floesche/LED-Display_G4_Hardware_Arena/arena_06-inf/arena_06-inf_teensy/assets/arena_06-inf_teensy_back.png

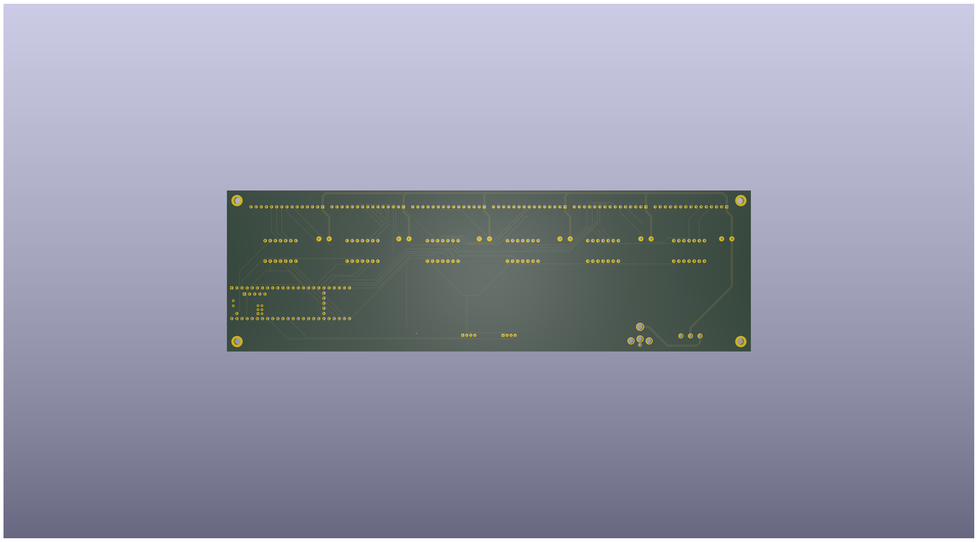
arena_06-inf/arena_06-inf_teensy/assets/arena_06-inf_teensy_back.png
