floesche/LED-Display_G4_Hardware_Arena/arena_12-12/arena_12-12_v8_ni/assets/arena_12-12_v8_ni_front.png

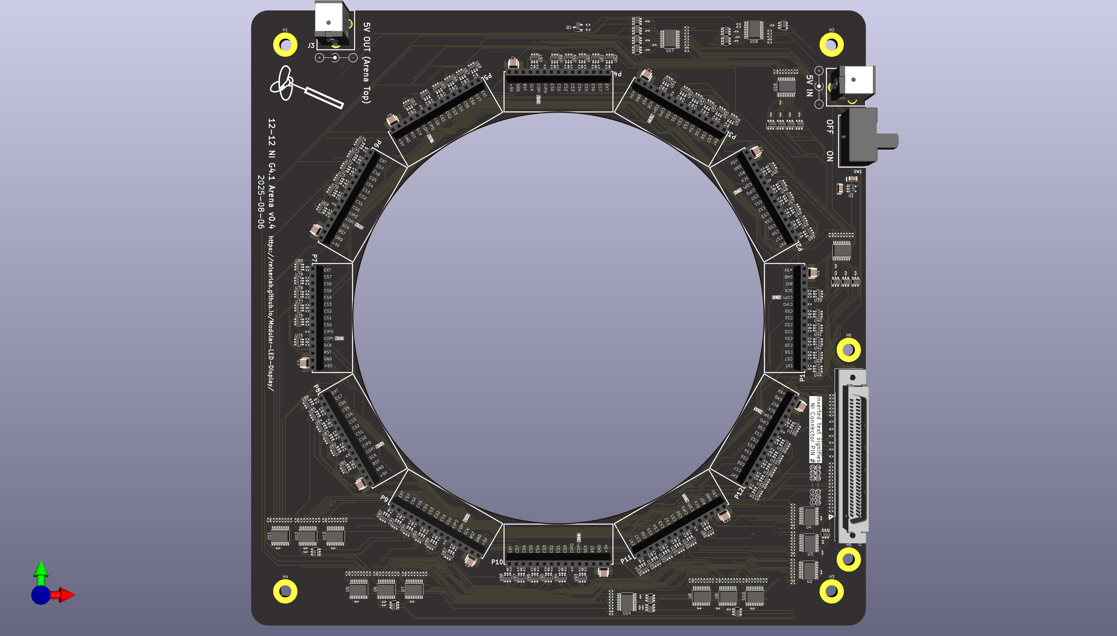
arena_12-12/arena_12-12_v8_ni/assets/arena_12-12_v8_ni_front.png
