floesche/LED-Display_G4_Hardware_Arena/arena_12-12/arena_12-12_v10_teensy/assets/arena_12-12_v10_teensy_back.png

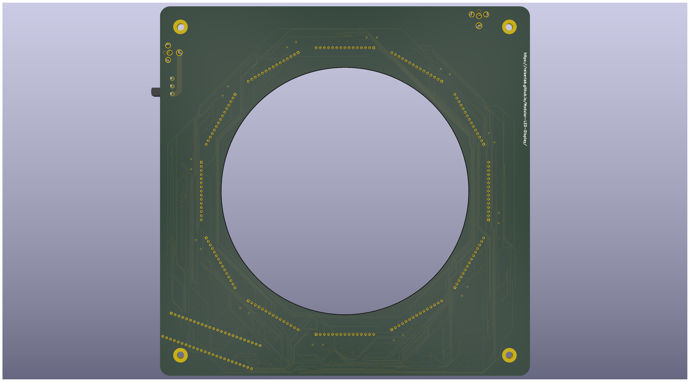
arena_12-12/arena_12-12_v10_teensy/assets/arena_12-12_v10_teensy_back.png
