floesche/LED-Display_G4_Hardware_Arena/arena_12-12/arena_12-12_v12_belt/assets/arena_12-12_v12_belt_back.png

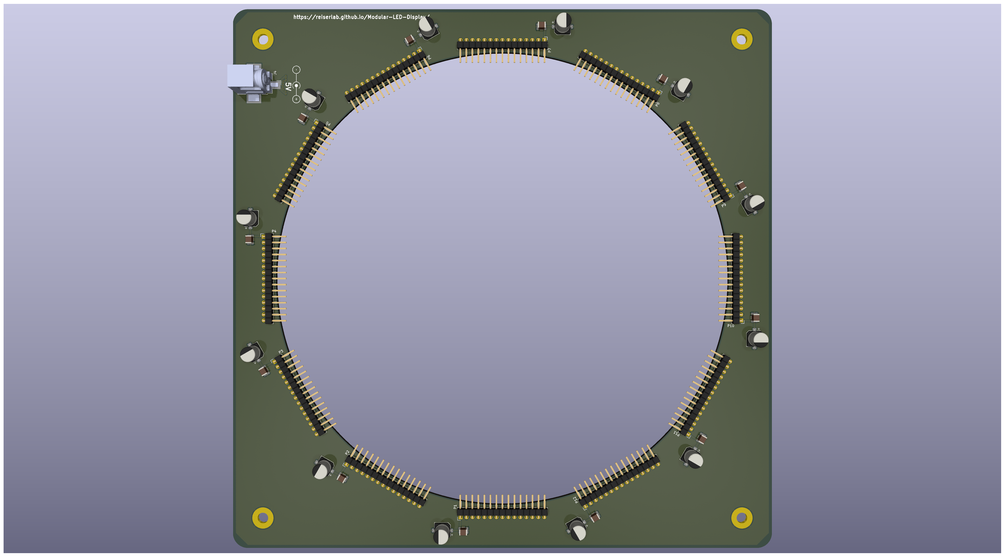
arena_12-12/arena_12-12_v12_belt/assets/arena_12-12_v12_belt_back.png
