floesche/LED-Display_G4_Hardware_Arena/docs/assets/arena_6-inf_v0p1_controller_photo.png

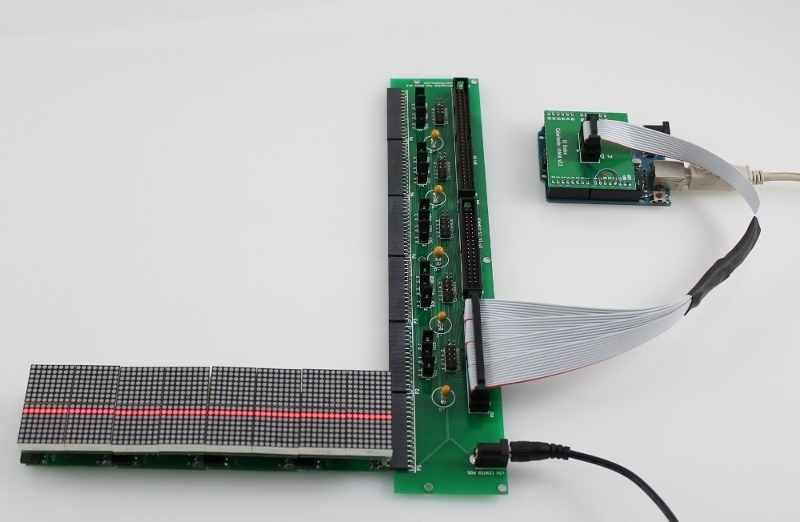
docs/assets/arena_6-inf_v0p1_controller_photo.png
