floesche/LED-Display_G4_Hardware_Arena/arena_06-inf/arena_06-inf_atmega328/production/BOM-v0p1.xls

Item # | Qty | Reference | Descritpion | P/N | Vendor
1 | 5 | C1-C5 | 10uF tantulum capacitor, 25V | 478-4170-ND | Digikey
2 | 6 | P1-P6 | 15x1 female header, right angle | S5490-ND or SAM1195-15-ND | Digikey
3 | 15 | P7-P21 | 2x2 male header, break away | S2011EC-40-ND | Digikey
4 | 2 | P22, P30 | 20x2 male header, shrouded | S9175-ND | Digikey
5 | 1 | P23 | 30x2 male header, shrouded | OR968-ND | Digikey
6 | 1 | P24 | 2.1mm DC Jack 2-pin | 137673 | Jameco
7 | 5 | P25-P29 | 5x2 male header | S2011EC-40-ND | Digikey
Extra
1 | 1 | P22,P30 | connector socket IDC 40 position | S9326-ND | Digikey
2 | 1 | P23 | connector socket IDC 60 position | OR978-ND | Digikey
