floesche/LED-Display_G4_Hardware_Arena/arena_06-inf/arena_06-inf_atmega328/production/BOM-v0p2.xls

Item # | Qty | Reference | Descritpion | P/N | Vendor
1 | 5 | C1-C5 | 10uF tantulum capacitor, 25V | 478-4170-ND | Digikey
2 | 6 | P1-P6 | 15x1 female header, right angle | S5490-ND or SAM1195-15-ND | Digikey
3 | 2 | P7, P10 | 20x2 male header, shrouded | S9175-ND | Digikey
4 | 1 | P8 | 68-pin DSUB for NI cable, TE Connectivity | A33476-ND | Digikey
5 | 1 | Q1 | MOSFET N-Channel | SI2302-TPMSCT-ND | Digikey
6 | 1 | R1 | Resistor, 200 SM0805 | RHM200KCT-ND | Digikey
7 | 1 | R2 | Resistor, 20k SM0805 | P20.0KCCT-ND | Digikey
8 | 1 | SW1 | Slide switch | CKC5102-ND | Digikey
9 | 1 | P9 | 2.1mm DC Jack 2-pin | 137673 | Jameco
Extra
1 | 1 | P22,P30 | connector socket IDC 40 position | S9326-ND | Digikey
2 | 1 | P23 | connector socket IDC 60 position | OR978-ND | Digikey
