floesche/LED-Display_G4_Hardware_Arena/arena_06-inf/arena_06-inf_atmega328/production/BOM-v0p3.xls

Item # | Qty | Reference | Descritpion | P/N | Vendor | unit price
1 | 5 | C1-C5 | 10uF tantulum capacitor, 25V | 478-4170-ND | Digikey | 0.98 | 24 | 23.52
2 | 6 | P1-P6 | 15x1 female header, right angle | S5490-ND or SAM1195-15-ND | Digikey | 2.26 | 12 | 27.12
3 | 2 | P7, P10 | 20x2 male header, shrouded | S9175-ND | Digikey | 0.91 | 2 | 1.82
4 | 1 | P8 | 68-pin DSUB for NI cable, TE Connectivity | A33476-ND | Digikey | 24.82 | 1 | 24.82
5 | 1 | Q1 | MOSFET N-Channel | SI2302-TPMSCT-ND | Digikey | 0.49 | 1 | 0.49
6 | 1 | R1 | Resistor, 200 SM0805 | RHM200KCT-ND | Digikey | 0.1 | 1 | 0.1
7 | 1 | R2 | Resistor, 20k SM0805 | P20.0KCCT-ND | Digikey | 0.1 | 1 | 0.1
8 | 6 | R3–R8 | Resistor 100Ohm | S100QCT-ND | Digikey | 0.1 | 12 | 1.2
9 | 1 | SW1 | Slide switch | CKC5102-ND | Digikey | 2.23 | 2 | 4.46
10 | 1 | P9 | 2.1mm DC Jack,high current | CP-063AH-ND | Digikey | 1.78 | 2 | 3.56
11 | 7 | U1-U7 | Voltage-Level Translator Breakout – TXB0104 | BOB-11771 | Sparkfun | 3.95 | 13 | 51.35
12 | 1 | U8 | 3.3V, 600mA step down voltage regulator | 2106 | Pololu | 5.95 | 1 | 5.95
 |  |  |  |  |  |  |  | 0
Extra |  |  |  |  |  |  |  | 0
1 | 2 | P22,P30 | connector socket IDC 40 position | S9326-ND | Digikey | 1.54 | 2 | 3.08
 |  |  |  |  |  | 1.6 | 6 | 9.6
 |  |  |  |  |  |  |  | 157.17 | 785.85
