floesche/LED-Display_G4_Hardware_Arena/arena_06-inf/arena_06-inf_max6960/production/BOM-v0p1.xls

Item # | Qty | Reference | Descritpion | P/N | Vendor
1 | 5 | C1-C5 | 10uF tantulum capacitor, 25V | 478-4170-ND | Digikey
2 | 1 | C6 | 0.1uF ceramic capacitor, SM0603 | 445-1316-1-ND | Digikey
3 | 6 | P1-P6 | 15x1 female header, right angle | S5490-ND, SAM1195-15-ND | Digikey
4 | 15 | P7-P21, P25 | 2x2 male header, break away | S2011EC-40-ND | Digikey
5 | 2 | P22, P32 | 20x2 male header, shrouded | S9175-ND | Digikey
6 | 1 | P23 | 30x2 male header, shrouded | OR968-ND | Digikey
7 | 2 | P24, P26 | 2.1mm DC Jack 2-pin | 137673 | Jameco
8 | 5 | P27-P31 | 5x2 male header | S2011EC-40-ND | Digikey
9 | 1 | U1 | MAX7375, | MAX7375AXR425+TCT-ND | Digikey
Extra
1 | 1 | P22,P30 | connector socket IDC 40 position | S9326-ND | Digikey
2 | 1 | P23 | connector socket IDC 60 position | OR978-ND | Digikey
