floesche/LED-Display_G4_Hardware_Arena/arena_06-inf/arena_06-inf_raspberry-pi/production/BOM-v0p1.xls

Item # | Qty | Reference | Descritpion | P/N | Vendor
1 | 5 | C1-C6 | 10uF tantalum capacitor, 25V | 478-4170-ND | Digikey
2 | 1 | J1 | 2.1mm DC Jack,high current | CP-063AH-ND | Digikey
3 | 6 | P1-P6 | 15x1 female header, right angle | SAM1195-15-ND | Digikey
4 | 1 | Q2 | MOSFET N-Channel | SI2302-TPMSCT-ND | Digikey
5 | 1 | R1 | Resistor, 200 Ohms, SM0805 | RHM200KCT-ND | Digikey
6 | 1 | R2 | Resistor, 20k SM0805 | P20.0KCCT-ND | Digikey
7 | 1 | SW1 | Slide switch | CKC5102-ND | Digikey
8 | 6 | U1-U6 | Voltage-Level Translator Breakout – TXB0104 | 1568-1208-ND | Digikey
9 | 1 | U10 | Raspberry Pi Pico RP2040 | 2648-SC0915CT-ND | Digikey
