floesche/LED-Display_G4_Hardware_Arena/arena_12-12/arena_12-12_v8_ni/production/version_0p3r4/bom_v0.3.4.csv

Designator | Footprint | Quantity | Value | LCSC Part #
C1, C10, C11, C12, C2, C3, C4, C5, C6, C7, C8, C9 | 1210 | 12 | 100uF | C7432790
C100, C101, C102, C103, C104, C105, C106, C107, C108, C109, C110, C111, C112, C113, C114, C115, C116, C117, C118, C119, C120, C121, C122, C123, C124, C125, C126, C127, C128, C129, C130, C131, C132, C133, C134, C135, C136, C137, C138, C139, C140, C15, C16, C17, C18, C19, C20, C21, C22, C23, C24, C25, C26, C27, C28, C29, C30, C31, C32, C33, C34, C35, C36, C37, C38, C39, C40, C41, C42, C43, C44, C45, C46, C47, C48, C49, C50, C51, C52, C53, C54, C55, C56, C57, C58, C59, C60, C61, C62, C63, C64, C65, C66, C67, C68, C69, C70, C71, C72, C73, C74, C75, C76, C77, C78, C79, C80, C81, C82, C83, C84, C85, C86, C87, C88, C89, C90, C91, C92, C93, C94, C95, C96, C97, C98, C99 | 0402 | 126 | 0.1uF | C1525
C13, C14 | 1206 | 2 | 10uF | C342827
J1, J3 | DCJACK_2PIN_HIGHCURRENT | 2 | Barrel_Jack | C2928097
J2 | TE_CONN_DSUB_VERT_68 | 1 | NI_TE_68pos | C5172587
P1, P10, P11, P12, P2, P3, P4, P5, P6, P7, P8, P9 | HEADER_TOP | 12 | CONN15 | C18078136
Q1 | SOT-23-3 | 1 | MOSFET_NCHAN | C165220
R1, R10, R100, R101, R102, R103, R104, R105, R106, R107, R108, R109, R11, R110, R111, R112, R113, R114, R115, R116, R117, R118, R119, R12, R120, R121, R122, R123, R124, R125, R126, R127, R128, R129, R13, R130, R131, R132, R133, R134, R135, R136, R137, R138, R139, R14, R140, R141, R142, R143, R144, R145, R146, R147, R148, R149, R15, R150, R151, R152, R153, R154, R155, R156, R157, R158, R159, R16, R160, R161, R162, R163, R164, R165, R166, R167, R168, R169, R17, R170, R171, R172, R173, R174, R175, R176, R177, R178, R179, R18, R180, R181, R182, R183, R184, R185, R186, R187, R188, R189, R19, R190, R191, R192, R193, R194, R195, R196, R197, R198, R199, R2, R20, R200, R201, R202, R203, R204, R205, R206, R207, R208, R209, R21, R210, R211, R212, R213, R214, R215, R216, R217, R218, R219, R22, R220, R221, R222, R223, R224, R225, R226, R227, R228, R229, R23, R230, R231, R232, R233, R234, R235, R236, R237, R238, R239, R24, R240, R241, R242, R243, R244, R245, R246, R247, R248, R249, R25, R250, R251, R252, R253, R254, R255, R256, R257, R258, R259, R26, R260, R261, R262, R263, R264, R265, R266, R267, R268, R269, R27, R270, R271, R272, R273, R274, R275, R276, R277, R278, R279 | 0402 | 200 | 33 | C25105
R28, R280, R281, R282, R283, R284, R285, R286, R287, R288, R289, R29, R290, R291, R292, R293, R294, R295, R296, R297, R298, R299, R3, R30, R300, R301, R302, R303, R304, R305, R306, R31, R32, R33, R34, R35, R36, R37, R38, R39, R4, R40, R41, R42, R43, R44, R45, R46, R47, R48, R49, R5, R50, R51, R52, R53, R54, R55, R56, R57, R58, R59, R6, R60, R61, R62, R63, R64, R65, R66, R67, R68, R69, R7, R70, R71, R72, R73, R74, R75, R76, R77, R78, R79, R8, R80, R81, R82, R83, R84, R85, R86, R87, R88, R89, R9, R90, R91, R92, R93, R94, R95, R96, R97, R98, R99 | 0402 | 106 | 33 | C25105
R307 | 0402 | 1 | 20k | C25765
R308 | 0402 | 1 | 200 | C25087
SW1 | slide_switch | 1 | SW_SPDT | C2798743
U1 | SOT-23-5 | 1 | AP2112K-3.3 | C51118
U10, U11, U12, U13, U14, U15, U16, U17, U18, U2, U3, U4, U5, U6, U7, U8, U9 | TSSOP-20_4.4x6.5mm_P0.65mm | 17 | TXB0108PW | C53406
U100, U101, U102, U103, U104, U105, U106, U107, U108, U109, U110, U19, U20, U21, U22, U23, U24, U25, U26, U27, U28, U29, U30, U31, U32, U33, U34, U35, U36, U37, U38, U39, U40, U41, U42, U43, U44, U45, U46, U47, U48, U49, U50, U51, U52, U53, U54, U55, U56, U57, U58, U59, U60, U61, U62, U63, U64, U65, U66, U67, U68, U69, U70, U71, U72, U73, U74, U75, U76, U77, U78, U79, U80, U81, U82, U83, U84, U85, U86, U87, U88, U89, U90, U91, U92, U93, U94, U95, U96, U97, U98, U99 | SOT-23-6 | 92 | 74LVC2G17 | C10429
