floesche/LED-Display_G4_Hardware_Arena/arena_06-inf/arena_06-inf_teensy/assets/arena_06-inf_teensy.step

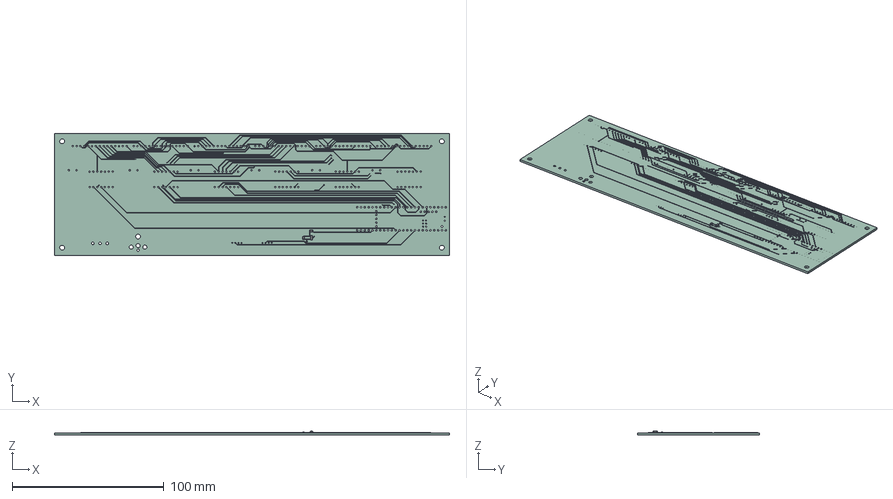
[picture p27: CAD file, 2025-11-14]
arena_06-inf/arena_06-inf_teensy/assets/arena_06-inf_teensy.step
260.0 x 80.0 x 2.83 mm
R_0805_2012Metric x 2
SOT-23-3
arena_06-inf_teensy_copper
arena_06-inf_teensy_via
arena_06-inf_teensy_PCB
