floesche/LED-Display_G4_Hardware_Arena/arena_12-12/arena_12-12_G4.1_top/assets/arena_top_12-12_0.4.2.step

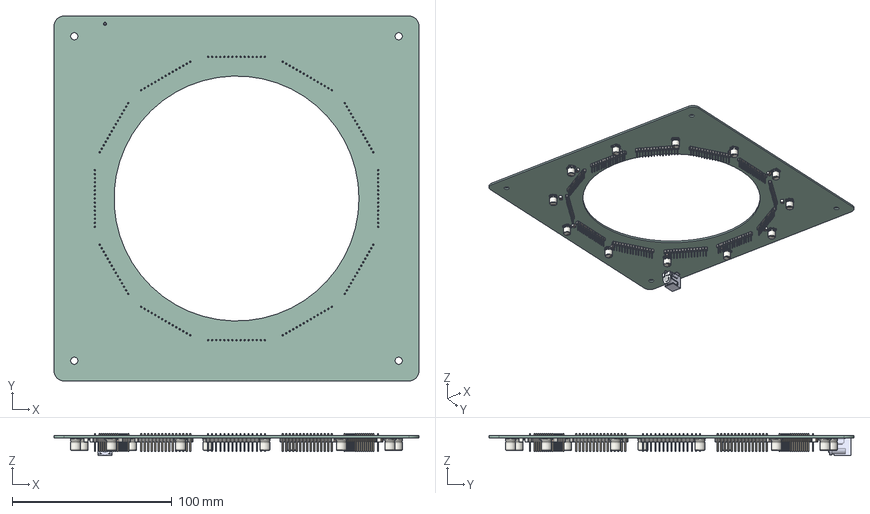
[picture p28: CAD file, 2025-07-25]
arena_12-12/arena_12-12_G4.1_top/assets/arena_top_12-12_0.4.2.step
228.6 x 228.6 x 14.0 mm
CP_Elec_6.3x7.7 x 12
C_1210_3225Metric x 12
Same_Sky_PJ-036AH-SMT-TR
PinHeader_1x15_P2.54mm_Vertical x 12
arena_top_12-12_PCB
