floesche/LED-Display_G4_Hardware_Arena/docs/assets/arena_12-12_v10_teensy_schematics.pdf

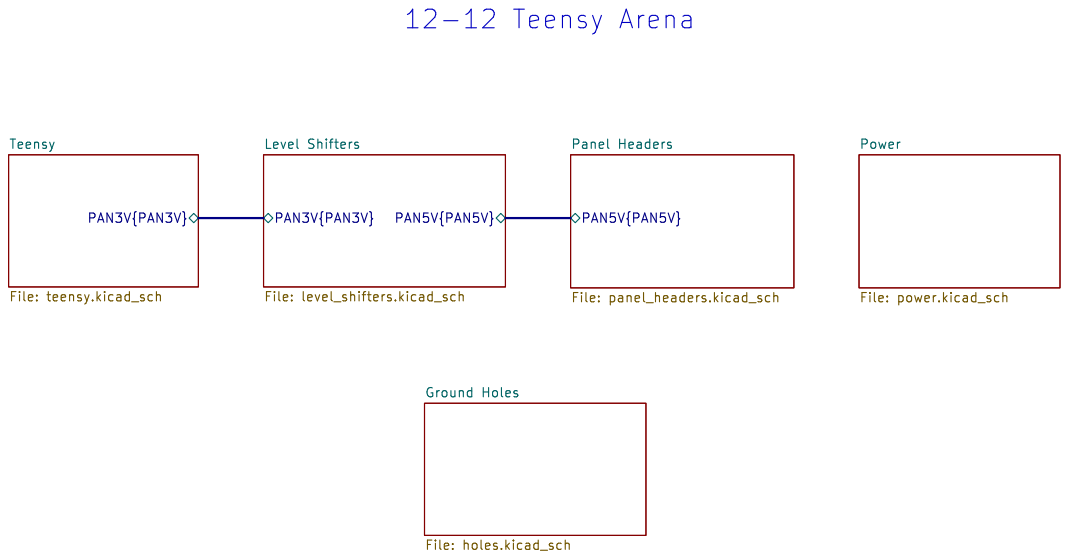
[picture p29: page 1]

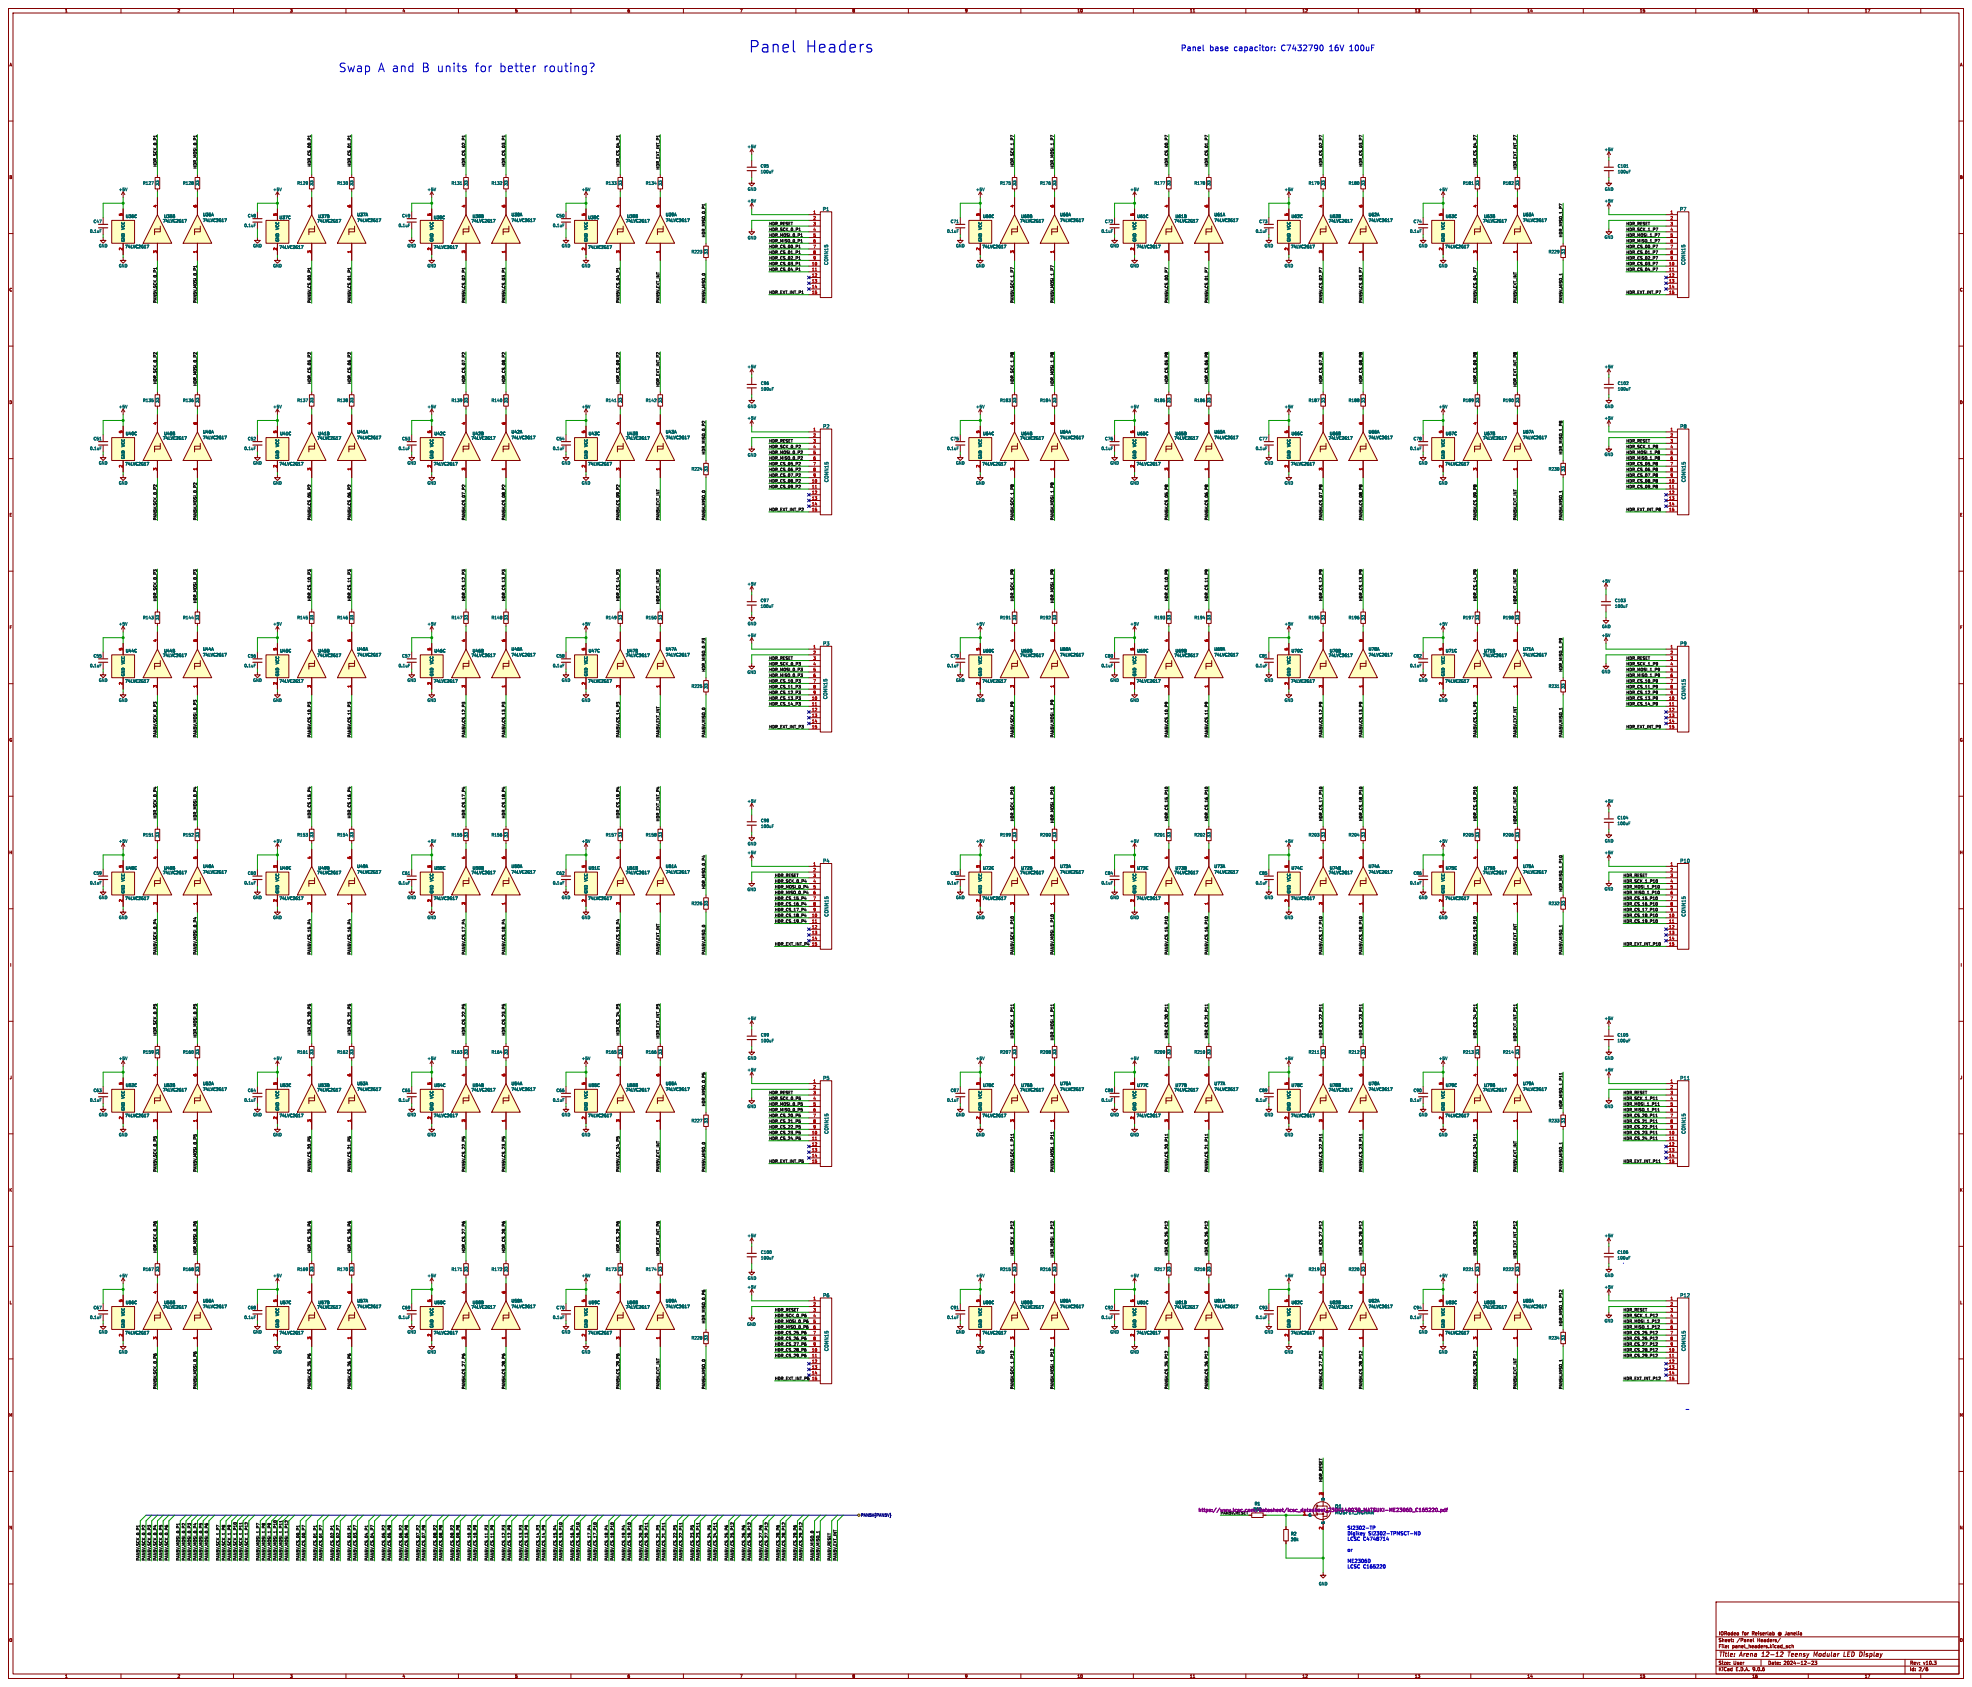
[picture p30: page 2]

Swap A and B units for better routing?

https://www.lcsc.com/datasheet/lcsc_datasheet_2304140030_MATSUKI-ME2306D_C165220.pdf

https://www.lcsc.com/datasheet/lcsc_datasheet_2304140030_MATSUKI-ME2306D_C165220.pdf G

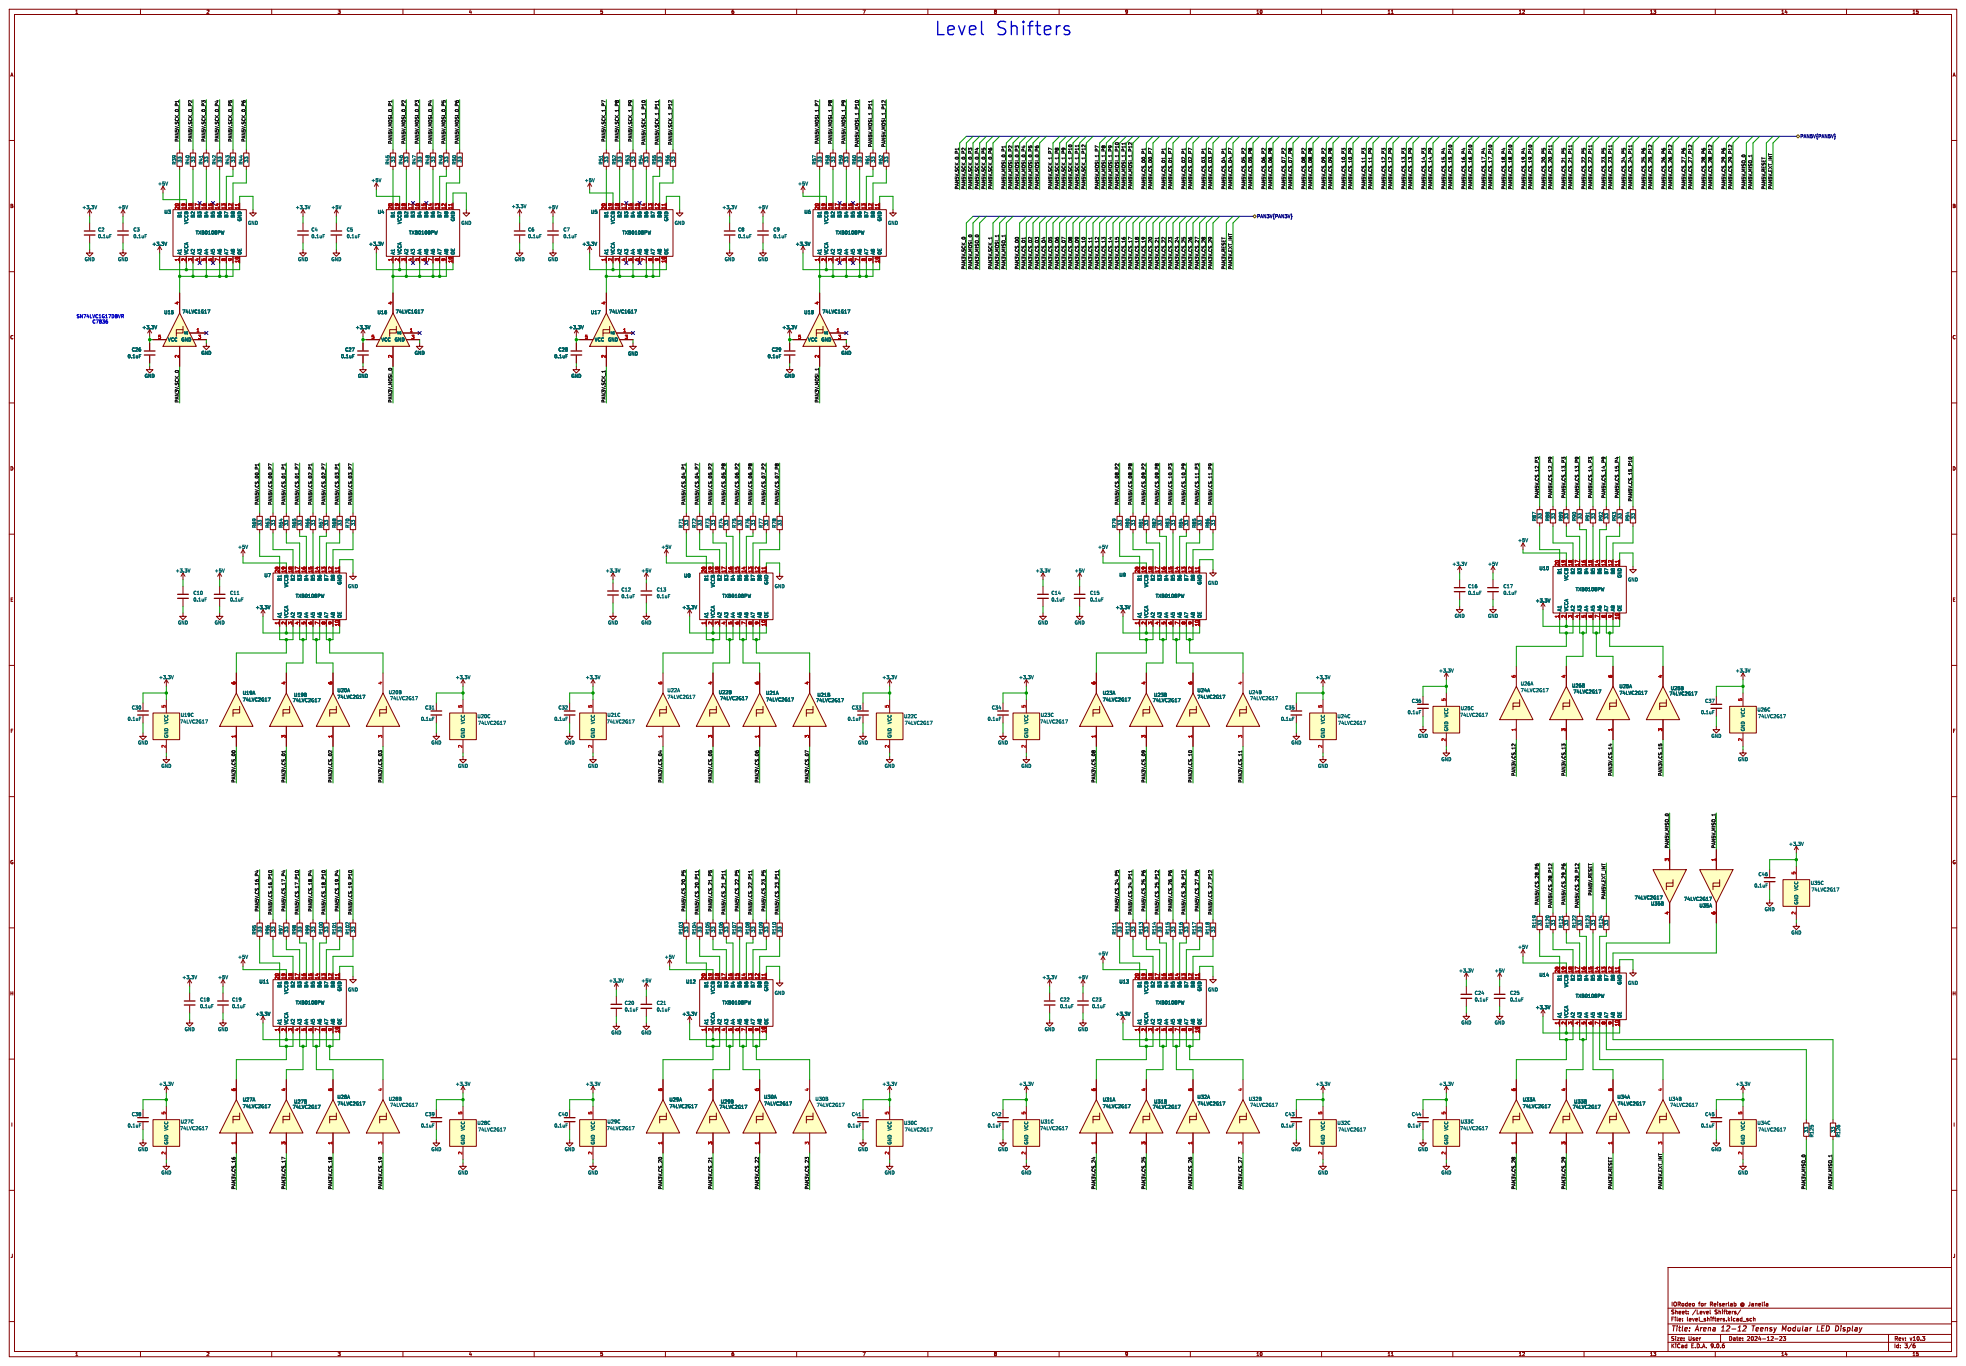
[picture p31: page 3]

9 OE 10 B1 20 VCCB 19 B2 18 B3 17 B4 16 B5 15 B6 14 B7 13 B8 12 GND 11 U3 TXB0108PW R83 33 R62 33 R86 33 R85 33 R84 33 R82 33 R81 33 R79 33 GND GND

9 OE 10 B1 20 VCCB 19 B2 18 B3 17 B4 16 B5 15 B6 14 B7 13 B8 12 GND 11 +3.3V GND

9 OE 10 B1 20 VCCB 19 B2 18 B3 17 B4 16 B5 15 B6 14 B7 13 B8 12 GND 11 U11 TXB0108PW VCC

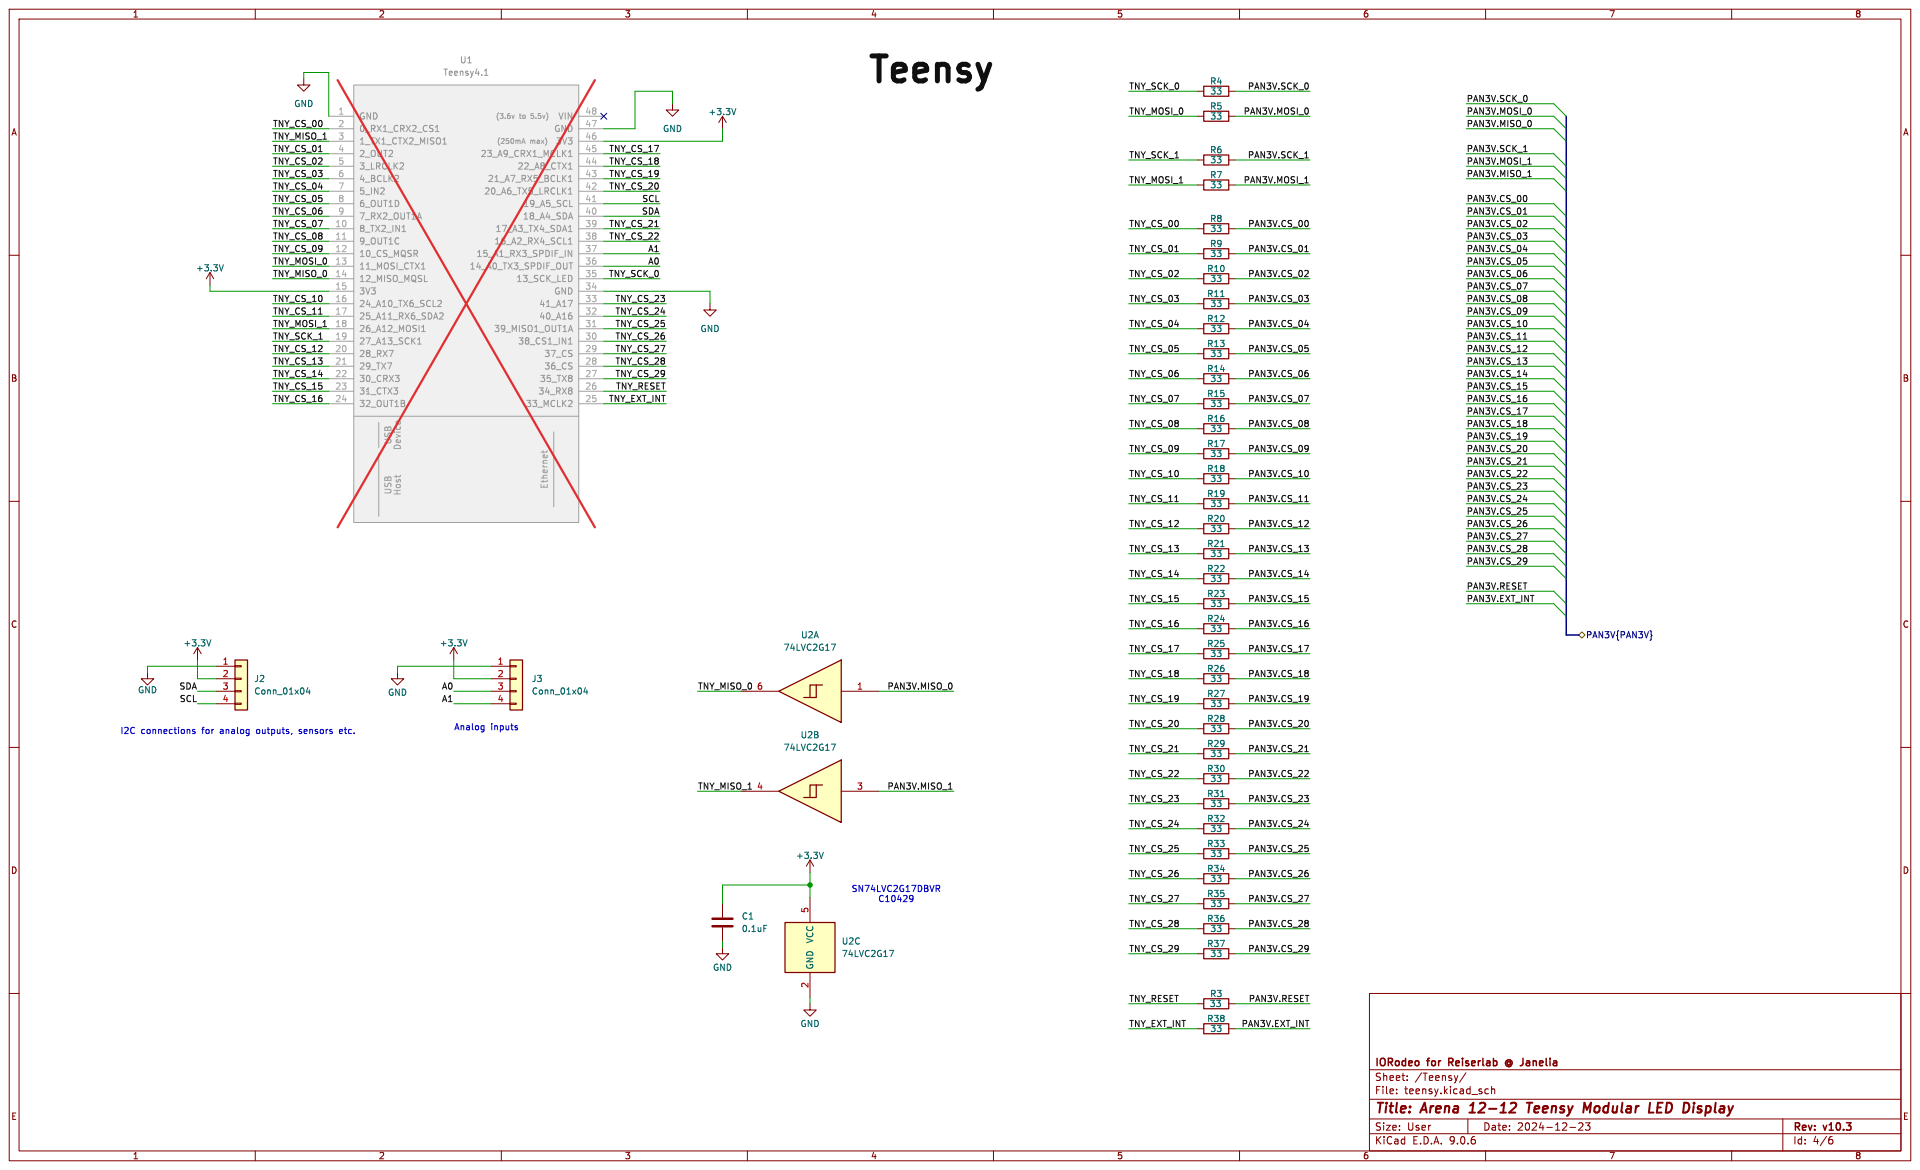
[picture p32: page 4]

33 GND USB USB Device Host

File: teensy.kicad_sch Sheet: /Teensy/

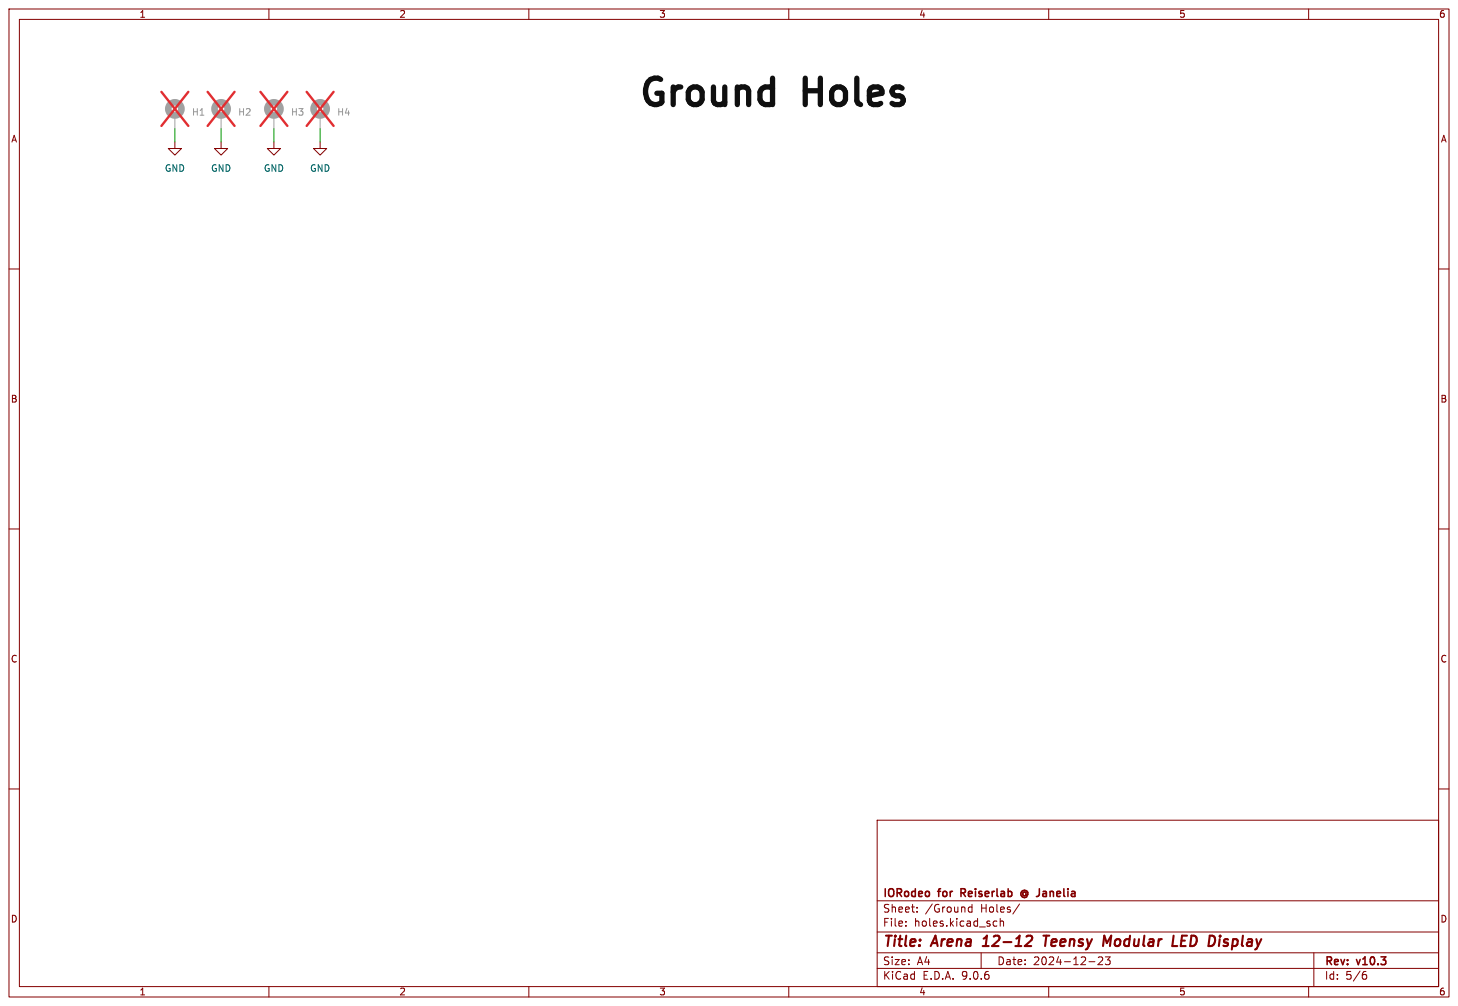
[picture p33: page 5]

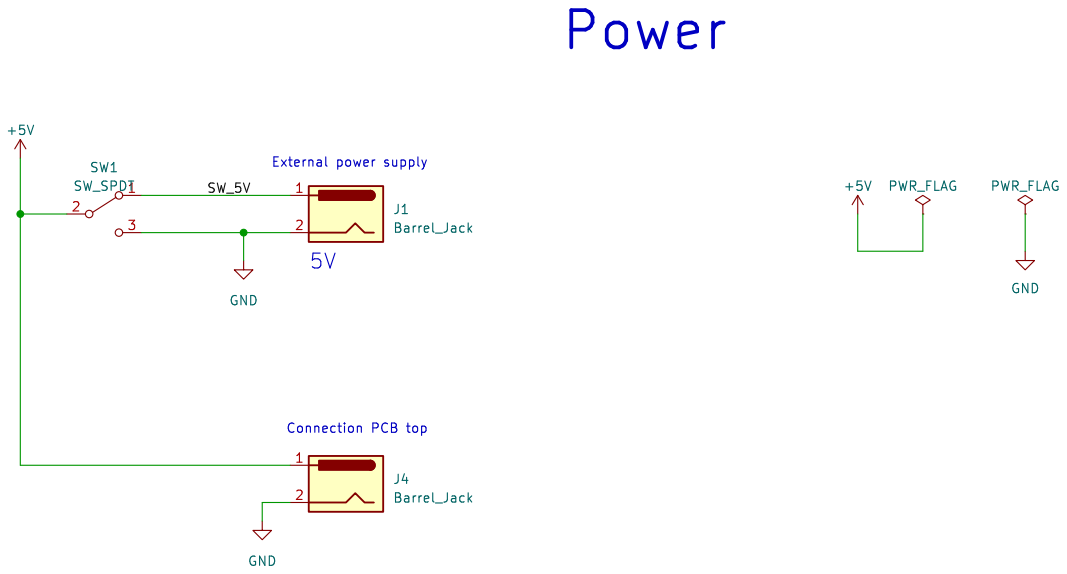
[picture p34: page 6]

File: power.kicad_sch Sheet: /Power/
