floesche/LED-Display_G4_Hardware_Arena/(commit log)

2025-02-24 Worked on schematic adding series termination resistors and buffers.
    [holes.kicad_sch, level_shifters.kicad_sch, ni_arena_12-12.kicad_pcb, ni_arena_12-12.kicad_sch, ni_connector.kicad_sch, panel_headers.kicad_sch, power.kicad_sch]
2025-02-24 More work on schematic adding resistos and buffers.
    [level_shifters.kicad_sch]
2025-02-24 Worked on adding schmitt trigger and series term. resistors to level shifter.
    [level_shifters.kicad_sch]
2025-02-25 Worked on 12-12 NI arena schematic.
    Added schmitt trigger buffers and series termination resistors to
    panels headers (not done).
    [level_shifters.kicad_sch, ni_connector.kicad_sch, panel_headers.kicad_sch]
2025-02-25 More work on 12-12 NI arena panels headers sheet.
    Changes schmitt trigger power to 5V instead 3.3V. Finished Panels
    column P9.
    [panel_headers.kicad_sch]
2025-02-25 Finished initial schematic for 12-12 NI with schmitt buffers.
    [level_shifters.kicad_sch, ni_arena_12-12.kicad_sch, ni_connector.kicad_sch, panel_headers.kicad_sch, power.kicad_sch]
2025-02-26 Worked on NI 12-12 arena schematic.
    Set up new bus definitions and started working through DRC issues.
    [level_shifters.kicad_sch, ni_arena_12-12.kicad_sch, ni_connector.kicad_sch, panel_headers.kicad_sch]
2025-02-26 ERC for NI 12-12 arena with schmitt buffers now passing.
    [level_shifters.kicad_sch, ni_arena_12-12.kicad_sch, ni_connector.kicad_sch, power.kicad_sch]
2025-02-26 Worked on 12-12 NI arena with schmitt buffers.
    Finished footprint assignments.
    [level_shifters.kicad_sch, ni_arena_12-12.kicad_pcb, ni_connector.kicad_sch, panel_headers.kicad_sch, power.kicad_sch]
2025-02-26 Wored on layout for 12-12 NI arena with schmitt buffers.
    Worked on layout for schmitt buffers and series term. resitors around
    at the base of a panel column.
    [ni_arena_12-12.kicad_pcb, ni_connector.kicad_sch, panel_headers.kicad_sch]
2025-02-27 Worked on 12-12 NI arena with schmitt buffers.
    Finalized layout of components at base of panel columns.
    [ni_arena_12-12.kicad_pcb]
2025-02-27 Worked on layout for 12-12 ni arena with schmitt buffers.
    Finished layout of components at base of panel columns.
    [level_shifters.kicad_sch, modified_ni_arena_12-12.kicad_pcb, ni_arena_12-12.kicad_pcb, panel_headers.kicad_sch, teensy_arena_12-12_copy.kicad_pcb]
2025-02-28 Worked on layout for 12-12 NI arena /w schmitt buffers.
    [level_shifters.kicad_sch, ni_arena_12-12.kicad_pcb]
2025-02-28 move working arena to release folder
    [BOM_JLCPCB_teensy_arena_12-12_v0p1_r1.xlsx, holes.kicad_sch, level_shifters.kicad_sch, modified_teensy_arena_12-12.kicad_pcb, nonlscs_bom_teensy_arena_12-12_v0p1_r1.xlsx, panel_headers.kicad_sch, power.kicad_sch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]
2025-02-28 move top arena to production
    [BOM_JLCPCB_arena_top_12-12_v0p1_r1.xlsx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]
2025-02-28 Worked on layout of 12-12 NI arena with schmitt buffers.
    Finished preliminary layout.
    [level_shifters.kicad_sch, ni_arena_12-12.kicad_pcb]
2025-02-28 Worked on 12-12 NI arena with schmitt buffers.
    Added silkscreen annotations.
    [ni_arena_12-12.kicad_pcb]
2025-03-18 Worked on routing and board setup.
    [ni_arena_12-12.kicad_pcb]
2025-03-19 Worked on routing for 12-12 NI arena.
    [ni_arena_12-12.kicad_pcb]
2025-03-24 Worked on routing 12-12 NI arena.
    [level_shifters.kicad_sch, ni_arena_12-12.kicad_pcb]
2025-03-25 Finished preliminary hand routing for NI 12-12 arena.
    [ni_arena_12-12.kicad_pcb, panel_headers.kicad_sch]
2025-03-25 Added copies of hand router for NI 12-12 arena. Create spectra DSN file.
    [ni_arena_12-12.dsn, ni_arena_12-12_hand_route.kicad_pcb, ni_arena_12-12_hand_route_copy.kicad_pcb, teensy_arena_12-12_pwr_gnd_route.kicad_pcb]
2025-03-27 Added several routed versions (.ses files etc) of the ni 12-12 arena.
    [ni_arena_12-12.dsn, ni_arena_12-12.kicad_pcb]
2025-03-28 Complete preliminary routing of ni 12-12 arena with schmitt buffers.
    [ni_arena_12-12.dsn, ni_arena_12-12.kicad_pcb]
2025-03-31 Finished autorouting for new route of NI 12-12 arena which fix hand route.
    [ni_arena_12-12.dsn, ni_arena_12-12.kicad_pcb, ni_arena_12-12_hand_route.kicad_pcb, ni_arena_12-12_hand_route_copy.kicad_pcb]
2025-03-31 Add new route to NI 12-12 .kicad_pcb file.
    [ni_arena_12-12.dsn, ni_arena_12-12.kicad_pcb, ni_arena_12-12_hand_route.kicad_pcb, ni_arena_12-12_hand_route_copy.kicad_pcb]
2025-04-01 Upgraded NI 12-12 arena w/ schmitt buffers to kicad 9.
    [holes.kicad_sch, level_shifters.kicad_sch, ni_arena_12-12.kicad_sch, ni_connector.kicad_sch, panel_headers.kicad_sch, power.kicad_sch]
2025-04-02 Worked on fabrication setup for NI 12-12 arena.
    Added part numbers, datasheets, etc. to symbol table.
    Deleted old productions files.
    [BOM_JLCPCB_teensy_arena_12-12_v0p1_r1.xlsx, holes.kicad_sch, level_shifters.kicad_sch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]
2025-04-02 Updated pcb from schematic so LCSC Part # appear in BOM file.
    [ni_connector.kicad_sch]
2025-04-03 Finished preliminary production setup for NI 12-12 arena with schmitt buffers.
    Note, rotation offsets may still adjusting (for 74LVC2G17's and Q1)
    [holes.kicad_sch, level_shifters.kicad_sch, ni_connector.kicad_sch, panel_headers.kicad_sch, teensy.kicad_sch, teensy_arena_12-12_tmp.kicad_pcb]
2025-04-21 project cleanup prior to ordering
    [BOM.xls, holes.kicad_sch, level_shifters.kicad_sch, ni_arena_12-12.dsn, ni_arena_12-12.kicad_pcb, ni_arena_12-12.kicad_sch, ni_arena_12-12_copy.kicad_pcb, ni_arena_12-12_hand_route.kicad_pcb]
2025-07-21 enable MCAD model with connectors
2025-07-22 rename top folders
    [BOM.xls, BOM_JLCPCB_arena_top_12-12_v0p1_r1.xlsx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]
2025-07-22 bump version
    [arena_top_12-12.kicad_pcb, arena_top_12-12.kicad_sch, holes.kicad_sch, panel_headers.kicad_sch, power.kicad_sch]
2025-07-22 One-sided version
    [arena_top_12-12.kicad_pcb, arena_top_12-12.kicad_sch, arena_top_12-12_0.4.step, holes.kicad_sch, panel_headers.kicad_sch, power.kicad_sch]
2025-07-22 add belt version
    [BOM_JLCPCB_arena_top_12-12_v0p1_r1.xlsx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]
2025-07-23 add BOMs and CPLs
    [bom.csv, designators.csv, positions.csv]
2025-07-23 add BOM and CPL for NI v0.3.4
    [bom_v0.3.4.csv, positions_v0.3.4.csv]
2025-07-24 cleanup, belt with SMD power connector
    [BOM_JLCPCB_arena_top_12-12_v0p1_r1.xlsx, arena_12-12_G4.1_belt.kicad_pcb, arena_12-12_G4.1_belt.kicad_sch, arena_12-12_G4.1_belt_v0.1.step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]
2025-07-25 cleanup top, v0.4.2
    [arena_top_12-12.kicad_pcb, arena_top_12-12.kicad_sch, arena_top_12-12_0.4.2.step, arena_top_12-12_0.4.step, holes.kicad_sch, level_shifters.kicad_sch, panel_headers.kicad_sch, power.kicad_sch]
2025-07-25 fix silkscreen
    [arena_12-12_G4.1_belt.kicad_pcb, arena_top_12-12.kicad_pcb]
2025-07-25 fix issues, bump to top-0.4.3 and belt-0.2
    [arena_12-12_G4.1_belt.kicad_pcb, arena_12-12_G4.1_belt.kicad_sch, arena_12-12_G4.1_belt_v0.2.step, arena_top_12-12.kicad_pcb, arena_top_12-12.kicad_sch, arena_top_12-12_0.4.3.step, holes.kicad_sch, panel_headers.kicad_sch]
2025-08-06 reroute arena to imitate G4
    [holes.kicad_sch, level_shifters.kicad_sch, ni_arena_12-12.kicad_sch, ni_connector.kicad_sch, panel_headers.kicad_sch, power.kicad_sch]
2025-08-06 add csv BOM etc
    [bom.csv, designators.csv, positions.csv]
2025-11-14 remove duplicate development arena for teensy 4.1
    [BOM.xls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]
2025-11-14 move ni w reg to v7
    [BOM_JLCPCB_ni_arena_12-12_v0p1_r1.xlsx, arena_12-12_v7_ni.kicad_pcb, arena_12-12_v7_ni.kicad_sch, holes.kicad_sch, level_shifters.kicad_sch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]
2025-11-14 migrate teensy w reg v0.1.1 to v9.1
    [BOM.xls, BOM_JLCPCB_teensy_arena_12-12_v0p1_r1.xlsx, arena_12-12_v8_ni.kicad_sch, arena_v12-12_v9_teensy.kicad_pcb, arena_v12-12_v9_teensy.kicad_sch, bom.csv, bom_v0.3.4.csv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]
2025-11-14 move with reg v0.2.1 to v9.2
    [BOM.xls, BOM_JLCPCB_teensy_arena_12-12_v0p1_r1.xlsx, BOM_JLCPCB_teensy_arena_12-12_v0p2_r1.xlsx, arena_12-12_v9_teensy.kicad_sch, arena_v12-12_v9_teensy.kicad_pcb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]
2025-11-14 v10.1, update README
    [BOM_JLCPCB_teensy_arena_12-12_v0p1_r1.xlsx, arena_12-12_v10_teensy.kicad_sch, holes.kicad_sch, level_shifters.kicad_sch, modified_teensy_arena_12-12.kicad_pcb, nonlscs_bom_teensy_arena_12-12_v0p1_r1.xlsx, panel_headers.kicad_sch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]
2025-11-14 add v10.3
    [BOM_JLCPCB_teensy_arena_12-12_v0p1_r1.xlsx, arena_12-12_v10_teensy.kicad_sch, holes.kicad_sch, level_shifters.kicad_sch, modified_teensy_arena_12-12.kicad_pcb, nonlscs_bom_teensy_arena_12-12_v0p1_r1.xlsx, panel_headers.kicad_sch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]
2025-11-14 integrate top in versions
    [BOM_JLCPCB_arena_top_12-12_v0p1_r1.xlsx, arena_12-12_G4.1_belt.kicad_pcb, arena_12-12_G4.1_belt.kicad_sch, arena_12-12_G4.1_belt_v0.1.step, arena_12-12_G4.1_belt_v0.2.step, arena_12-12_v11_top.kicad_pcb, arena_12-12_v11_top.kicad_sch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]
2025-11-14 add schematics and renderings to arena docs
2026-04-27 new version of the interconnect
    - update components
    - rerouting
    [interconnect_v3.kicad_pcb, interconnect_v3.kicad_sch]
2026-06-16 update documentation for G4 and G4.1 Arenas
    [interconnect_v3.kicad_pcb, interconnect_v3.kicad_sch]
2026-09-02 re-export v10.3.3
    [arena_12-12_v10_teensy.kicad_pcb, arena_12-12_v10_teensy.kicad_sch, bom.csv, designators.csv, holes.kicad_sch, level_shifters.kicad_sch, panel_headers.kicad_sch, positions.csv]
